nhuquynh112/Smart-Green/docs/AI_TRAIN_W01_2026-11-12.md

# BÁO CÁO THỰC NGHIỆM AI W01

**Dự án:** Smart Garden
**Ngày tổng hợp:** 12/11/2026
**Nguồn dữ liệu:** Phiên thu thập W01 ngày 11/11/2026

## 1. Mục tiêu

Đánh giá khả năng dự đoán chỉ số độ ẩm đất sau 30 và 60 phút.
Dữ liệu W01 được thu thập từ hệ thống ESP32 và cảm biến thực tế.

## 2. Dữ liệu và phương pháp

- Dữ liệu thực tế: 1.062 bản ghi telemetry.
- Dữ liệu sau tổng hợp: 530 mốc thời gian theo phút.
- Thiết bị: garden-01.
- Calibration: soil-2511-979.
- Chỉ số soil_pct là độ ẩm tương đối theo hiệu chuẩn cảm biến,
  không phải độ ẩm thể tích thực tế của đất.
- Chia Train / Validation / Test theo thứ tự thời gian.
- Loại bỏ các cửa sổ không hợp lệ hoặc giao nhau ở ranh giới chia tập.

## 3. Phương pháp dự đoán

- Linear Regression: mô hình Machine Learning được huấn luyện.
- Random Forest: mô hình Machine Learning được huấn luyện.
- Persistence: baseline giữ nguyên giá trị hiện tại.
- Linear Extrapolation: baseline ngoại suy xu hướng gần đây.

## 4. Kết quả thực nghiệm

MAE được tính bằng điểm phần trăm của chỉ số soil_pct đã hiệu chuẩn.

### 4.1. Dự đoán 30 phút

- Train: 259 mẫu.
- Validation: 67 mẫu.
- Test: 97 mẫu.
- Được chọn theo Validation: **Persistence (Hold-last)**.

| Phương pháp | Validation MAE | Test MAE |
|---|---:|---:|
| Persistence (Hold-last) | 0,2289 | 0,4805 |
| Linear Extrapolation | 0,5660 | 0,6655 |
| Linear Regression | 0,7369 | 4,7774 |
| Random Forest | 0,4917 | 0,8120 |

Phương pháp có Test MAE thấp nhất: **Persistence (Hold-last) (0,4805)**.

### 4.2. Dự đoán 60 phút

- Train: 211 mẫu.
- Validation: 31 mẫu.
- Test: 91 mẫu.
- Được chọn theo Validation: **Random Forest**.

| Phương pháp | Validation MAE | Test MAE |
|---|---:|---:|
| Persistence (Hold-last) | 0,3990 | 0,4939 |
| Linear Extrapolation | 0,9233 | 1,0526 |
| Linear Regression | 2,5606 | 14,7073 |
| Random Forest | 0,3741 | 0,8017 |

Phương pháp có Test MAE thấp nhất: **Persistence (Hold-last) (0,4939)**.

## 5. Đánh giá

Kết quả W01 cho thấy các mô hình Machine Learning chưa vượt
qua baseline Persistence trên tập Test ở cả hai mốc dự đoán.

Random Forest được chọn theo Validation ở mốc 60 phút,
nhưng Persistence vẫn có sai số thấp hơn trên tập Test.

Không sử dụng tập Test để chọn lại mô hình hoặc điều chỉnh tham số.

## 6. Giới hạn

- W01 chỉ gồm một phiên thu thập thực tế.
- Các cửa sổ thời gian có tương quan, không phải thử nghiệm độc lập.
- Kết quả chỉ đánh giá dự đoán trong giai đoạn không tưới thêm.
- Chưa đủ cơ sở cho phép AI tự động điều khiển máy bơm.

## 7. Kế hoạch W02 và W03

1. Thu thập các phiên dữ liệu mới khi cây thực sự cần tưới.
2. Giữ nguyên mô hình W01 khi đánh giá độc lập.
3. So sánh dự đoán với dữ liệu thực tế và tính MAE mới.
4. Đánh giá khả năng tổng quát hóa trước khi cân nhắc train lại.

## 8. Tệp kết quả

- `artifacts/ai-train-w01-20261112/horizon-30/report.json`
- `artifacts/ai-train-w01-20261112/horizon-60/report.json`
- `artifacts/ai-report-w01-20261112/horizon-30/index.html`
- `artifacts/ai-report-w01-20261112/horizon-60/index.html`

**Trạng thái:** Hoàn thành thực nghiệm W01; chờ đánh giá W02/W03.

## 9. Tái lập và kiểm tra dữ liệu

Input: `artifacts/session-2026-11-11/minute-data.csv`.
SHA256: `3058d51a6dfe47415dec3039d4f9db3bf89edc0fabcc9d05b890caedb6cdb594`.
530 phút từ 12:13 đến 21:02 ngày 11/11/2026 (UTC+07). Timestamp có múi giờ,
đúng thứ tự, không trùng. Hai phút tưới 12:13–12:14 được loại, còn 528 phút có đủ dữ liệu.
Không nội suy qua dữ liệu thiếu. Có 483/453 cửa sổ hợp lệ cho horizon 30/60 phút.
`watering_counter_increments=0` trong tập hợp lệ không có nghĩa phiên này không tưới:
sự kiện tưới ở đầu phiên đã được loại khỏi các cửa sổ đánh giá.

Feature version: `v2-watering-events`. Chín feature: `soil_pct`, `soil_lag_5`,
`soil_lag_15`, `slope_15`, `temperature_c`, `humidity_pct`, `minutes_since_water`,
`hour_sin`, `hour_cos`. Lịch sử phải có 16 phút liên tiếp hợp lệ, không tưới trong
15 phút trước; nhãn chỉ lấy trong tương lai đủ dữ liệu và không tưới thêm.
Hour sin/cos tính theo UTC. Chia thời gian 60/20/20 rồi loại nhãn vượt ranh giới.

Phiên bản ghi trong artifact: {"python": "3.12.3", "numpy": "2.5.4", "pandas": "3.1.1", "sklearn": "1.9.1", "joblib": "1.6.0"}.
Random Forest: 150 cây, max_depth=8, min_samples_leaf=10, random_state=42, n_jobs=1.
Dự đoán tất cả phương pháp được giới hạn trong [0,100].

### Ranh giới tập (UTC)

| Horizon | Tập | Số cửa sổ | Thời điểm feature đầu | Cuối | Nhãn cuối |
|---|---|---:|---|---|---|
| 30 | train | 259 | 2026-11-11T05:30:00+00:00 | 2026-11-11T09:48:00+00:00 | 2026-11-11T10:18:00+00:00 |
| 30 | validation | 67 | 2026-11-11T10:19:00+00:00 | 2026-11-11T11:25:00+00:00 | 2026-11-11T11:55:00+00:00 |
| 30 | test | 97 | 2026-11-11T11:56:00+00:00 | 2026-11-11T13:32:00+00:00 | 2026-11-11T14:02:00+00:00 |
| 60 | train | 211 | 2026-11-11T05:30:00+00:00 | 2026-11-11T09:00:00+00:00 | 2026-11-11T10:00:00+00:00 |
| 60 | validation | 31 | 2026-11-11T10:01:00+00:00 | 2026-11-11T10:31:00+00:00 | 2026-11-11T11:31:00+00:00 |
| 60 | test | 91 | 2026-11-11T11:32:00+00:00 | 2026-11-11T13:02:00+00:00 | 2026-11-11T14:02:00+00:00 |

### Nhóm test giảm ẩm

Điều kiện hồi cứu: target < soil hiện tại. Đây không phải tín hiệu điều khiển,
không phải các chu kỳ độc lập. MAE đơn vị điểm phần trăm chỉ số hiệu chuẩn.

| Horizon | Số mẫu | Phương pháp | MAE giảm ẩm |
|---|---:|---|---:|
| 30 | 50 | persistence | 0.718668 |
| 30 | 50 | linear_extrapolation | 0.853133 |
| 30 | 50 | linear_regression | 5.615769 |
| 30 | 50 | random_forest | 0.762505 |
| 60 | 37 | persistence | 0.839743 |
| 60 | 37 | linear_extrapolation | 1.571872 |
| 60 | 37 | linear_regression | 17.511765 |
| 60 | 37 | random_forest | 0.806066 |

### Lệnh tái lập

Chạy từ thư mục gốc repo. Đây là lệnh tái lập theo CLI hiện tại, không phải bản ghi
shell của lần train ban đầu. Dùng thư mục mới; train nay từ chối cả thư mục đã tồn tại
nhưng rỗng. Không chạy lại vào thư mục W01 gốc. Nếu cần chạy lần nữa, đổi tên run.

```bash
PYTHONPATH=ai .venv-ai/bin/python -m smart_green_ai.assess artifacts/session-2026-11-11/minute-data.csv --horizon 30
PYTHONPATH=ai .venv-ai/bin/python -m smart_green_ai.assess artifacts/session-2026-11-11/minute-data.csv --horizon 60
PYTHONPATH=ai .venv-ai/bin/python -m smart_green_ai.train artifacts/session-2026-11-11/minute-data.csv --horizon 30 --output artifacts/w01-reproduction-01/horizon-30
PYTHONPATH=ai .venv-ai/bin/python -m smart_green_ai.train artifacts/session-2026-11-11/minute-data.csv --horizon 60 --output artifacts/w01-reproduction-01/horizon-60
```

Pipeline readiness đạt cho huấn luyện offline. Model performance là MAE trên phần
W01 giữ lại. Real-world reliability chưa được chứng minh; cần W02/W03 độc lập.
Giữ `automatic_irrigation_approved=false`. Không đổi candidate theo kết quả test.

## 10. Kiểm thử và bảo toàn phiên thu

Review 12/11: đối chiếu hash dataset, nhãn, MAE tính lại từ CSV và dự đoán của candidate
đều khớp; kiểm tra nhãn train/validation nằm trước tập kế tiếp.
Lượt review trước: 33 test AI/dataset đạt; 38 test tools và 8 subtest đạt (có phần trùng).
Kiểm thử firmware native đạt, chỉ là mô phỏng host, không thay thế thử thiết bị.

Bản sửa bảo vệ output chỉ nằm trong CLI train offline, không đổi inference/backend.
Không restart dịch vụ, không truy vấn/ghi database và không nạp firmware trong lần hoàn thiện này.
Dữ liệu W02 đang thu không được dùng để chỉnh mô hình W01.

Lượt kiểm thử sau sửa chặn ghi đè:
```bash
.venv-ai/bin/python -m pytest ai/tests tools/tests/test_build_ai_dataset.py -q
git diff --check
```
Kết quả: **37 passed**, không failed/skipped; `git diff --check` sạch.
