nhuquynh112/Smart-Green/docs/W01_HANDOFF_2026-11-12.md

# Bàn giao W01 và thay đổi local — 12/11/2026

## Phần đã có trong Git

Branch `tv1/firmware-ai-foundation`, HEAD tại thời điểm review `6af4423`.
Remote-tracking local trùng HEAD; chưa fetch để xác nhận trạng thái máy chủ.

## Phần hoàn thiện AI

- `ai/smart_green_ai/train.py`: từ chối output đã tồn tại, mkdir độc quyền trước export.
- `ai/tests/test_pipeline.py`: 4 trường hợp bảo vệ thư mục/file/symlink và candidate cũ.
- `docs/AI_TRAIN_W01_2026-11-12.md`: dữ liệu, phiên bản, tái lập, MAE giảm ẩm và test.
- `docs/w01-evidence/`: hai report JSON nhỏ cùng manifest checksum, có thể lưu Git.
- Tài liệu bàn giao này.

## Nhóm backend được bàn giao riêng

Đã lưu trong commit `35731a2`. Danh sách dưới đây mô tả trạng thái trước commit.

`backend/app.py`, `backend/database.py`, `backend/static/index.html`,
`backend/tests/dashboard_controls.test.cjs`, `backend/tests/test_api.py`,
`db/schema.sql`, `docs/TV1_REMAINING_TASKS.md` đã sửa.
`backend/tests/test_command_postgres.py`, `docs/CODE_REVIEW_2026-11-12.md` chưa được track.
Nhóm backend được kiểm thử offline và commit riêng với nhóm AI. Không triển khai trong phiên W02.

## Sao lưu kết quả nằm ngoài Git

`artifacts/w01-handoff-20261112/w01-data-models-reports.zip` gồm snapshot W01,
candidate và báo cáo đồ thị. Tất cả thành viên được kiểm tra SHA256 với tệp nguồn
và archive được kiểm tra CRC. Manifest tại `docs/w01-evidence/backup-manifest.json`.
Patch working tree và hai tệp untracked có trước được lưu riêng trong cùng thư mục bàn giao.
Archive không chứa W02, database đang chạy, .env hoặc cấu hình thiết bị bí mật.

Đây là bản sao local cùng ổ đĩa, chưa phải backup ngoài máy. Git vẫn bỏ qua `artifacts/`
và model nhị phân. Khi kết thúc phiên thu, sao chép archive sang ổ khác hoặc nơi lưu trữ
của nhóm và kiểm tra lại SHA256. Không force-add toàn bộ artifacts vào Git.

## Git và phiên W02

Người dùng đã cho phép commit/push ngày 12/11/2026. Việc lưu Git không triển khai dịch vụ.
Commit AI: `feat(ai): preserve W01 evidence and prevent candidate overwrite`.
Không restart backend, sửa DB, gửi lệnh bơm, flash hoặc đổi cấu hình đang thu.
