nhuquynh112/Smart-Green/firmware/src/bringup.cpp

// Explicit includes allow PlatformIO's dependency scanner to find libraries used by the sketch.
#include <Arduino.h>
#include <ArduinoJson.h>
#include <DHT.h>
#include <Preferences.h>
#include "../bringup/bringup.ino"
