nhuquynh112/Smart-Green/(commit log)

2026-11-07 feat(firmware): complete ESP32 hardware bring-up
2026-11-08 fix(firmware): unify runtime telemetry and persist measurement timestamps
    [main.cpp, runtime_config.h, runtime_profile.h, site_config.example.h, telemetry_time.h]
2026-11-08 fix(data): report invalid sensor minutes and expand TV1 offline validation
    [build_ai_dataset.py]
